toghrul-guluzade/AzSat-CanSat-APRSAF2025/images/image1.png

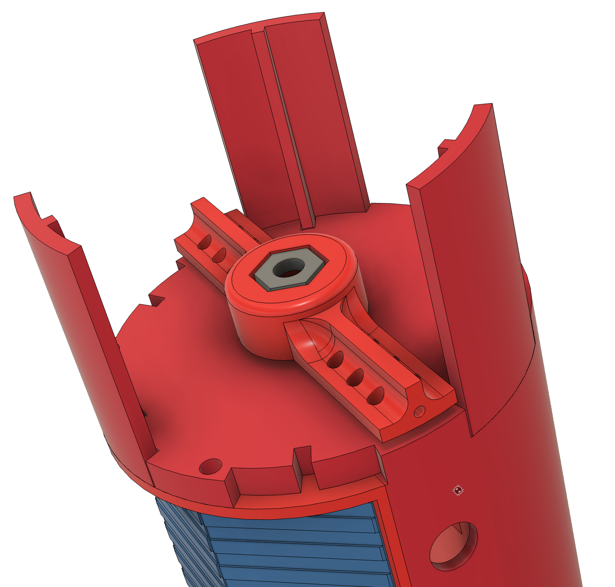
images/image1.png
