toghrul-guluzade/AzSat-CanSat-APRSAF2025/images/image2.png

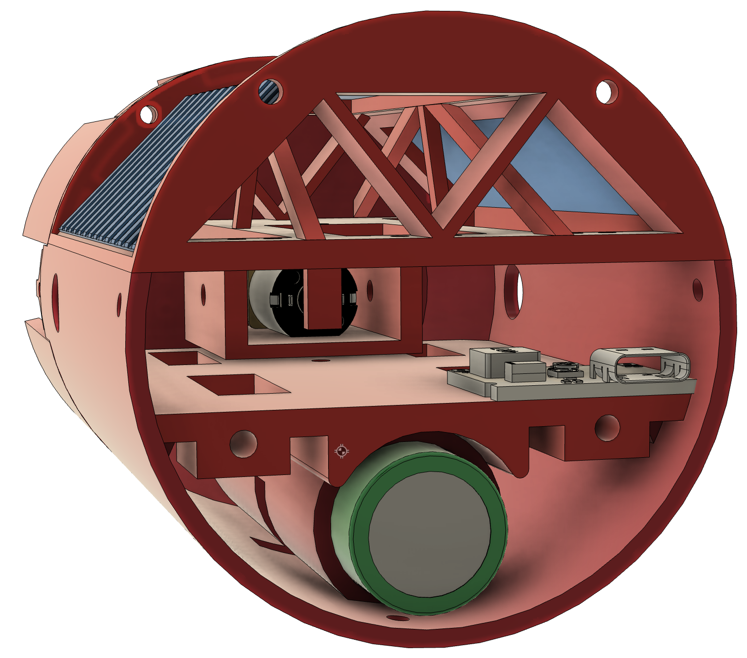
images/image2.png
