toghrul-guluzade/AzSat-CanSat-APRSAF2025/images/image3.png

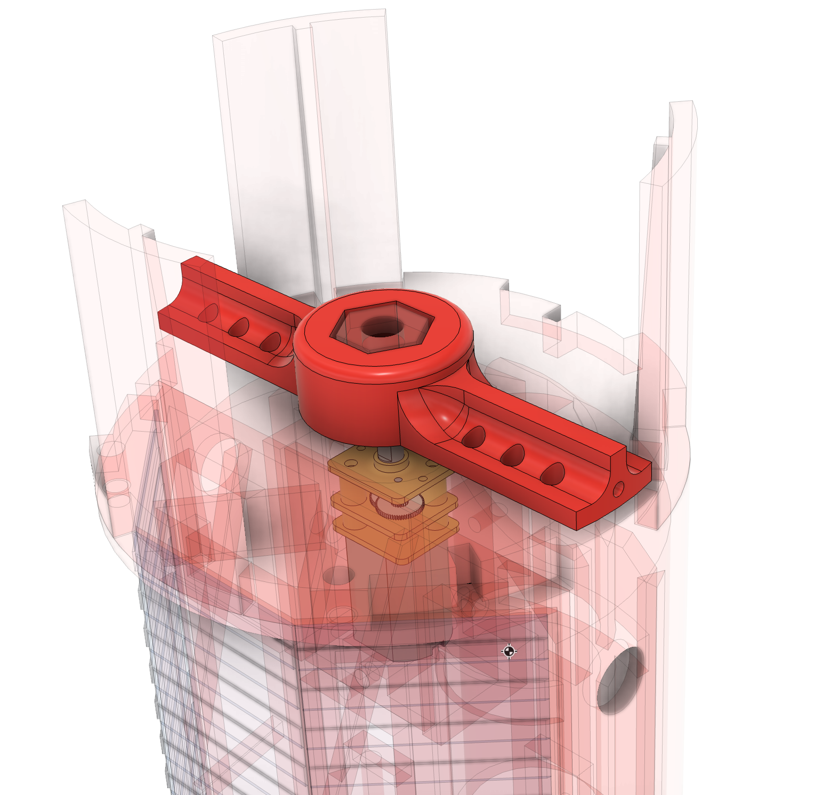
images/image3.png
