toghrul-guluzade/AzSat-CanSat-APRSAF2025/docs/MainAssemb Drawing v1.pdf

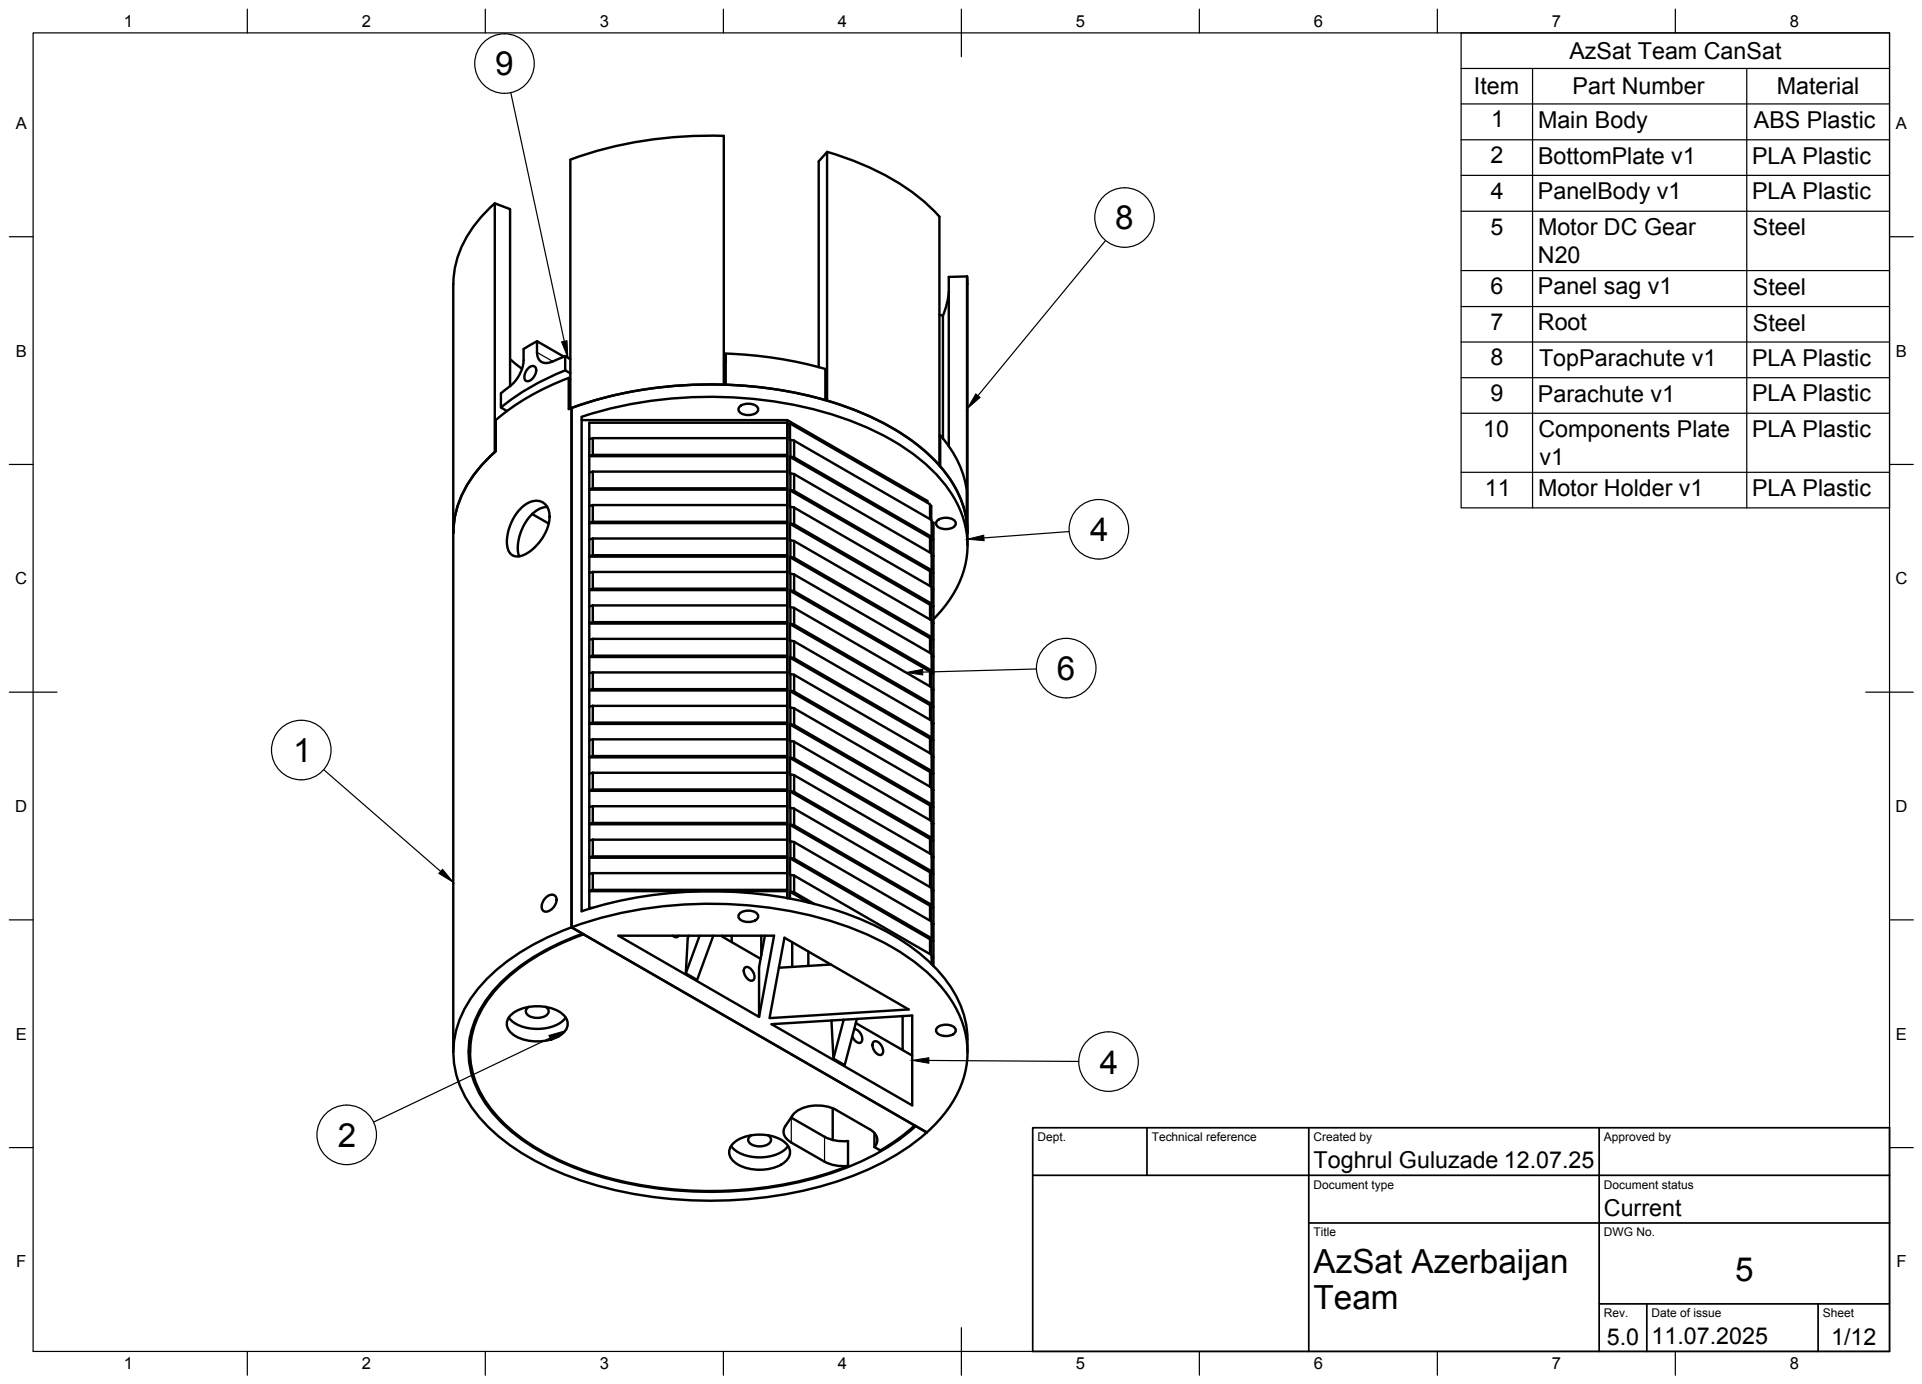
[picture p14: page 1]
8 BCDEF; ABCDEF; Title; DWG No.; Rev.; Date of issue; Sheet; AzSat Azerbaijan; Components Plate; PLA Plastic; Motor Holder v1; PLA Plastic 1 2

AzSat Team CanSat

Item | PanelBody v1 Main Body BottomPlate v1 Motor DC Gear Part Number | PLA Plastic 4 PLA Plastic 5 ABS Plastic 2 Material 1

Panel sag v1 Root Parachute v1 TopParachute v1 | PLA Plastic 9 PLA Plastic Steel 6 Steel 7 Steel 8
N20

Dept. | Technical reference | Created by Toghrul Guluzade 12.07.25 | Approved by

Document type | Document status Current

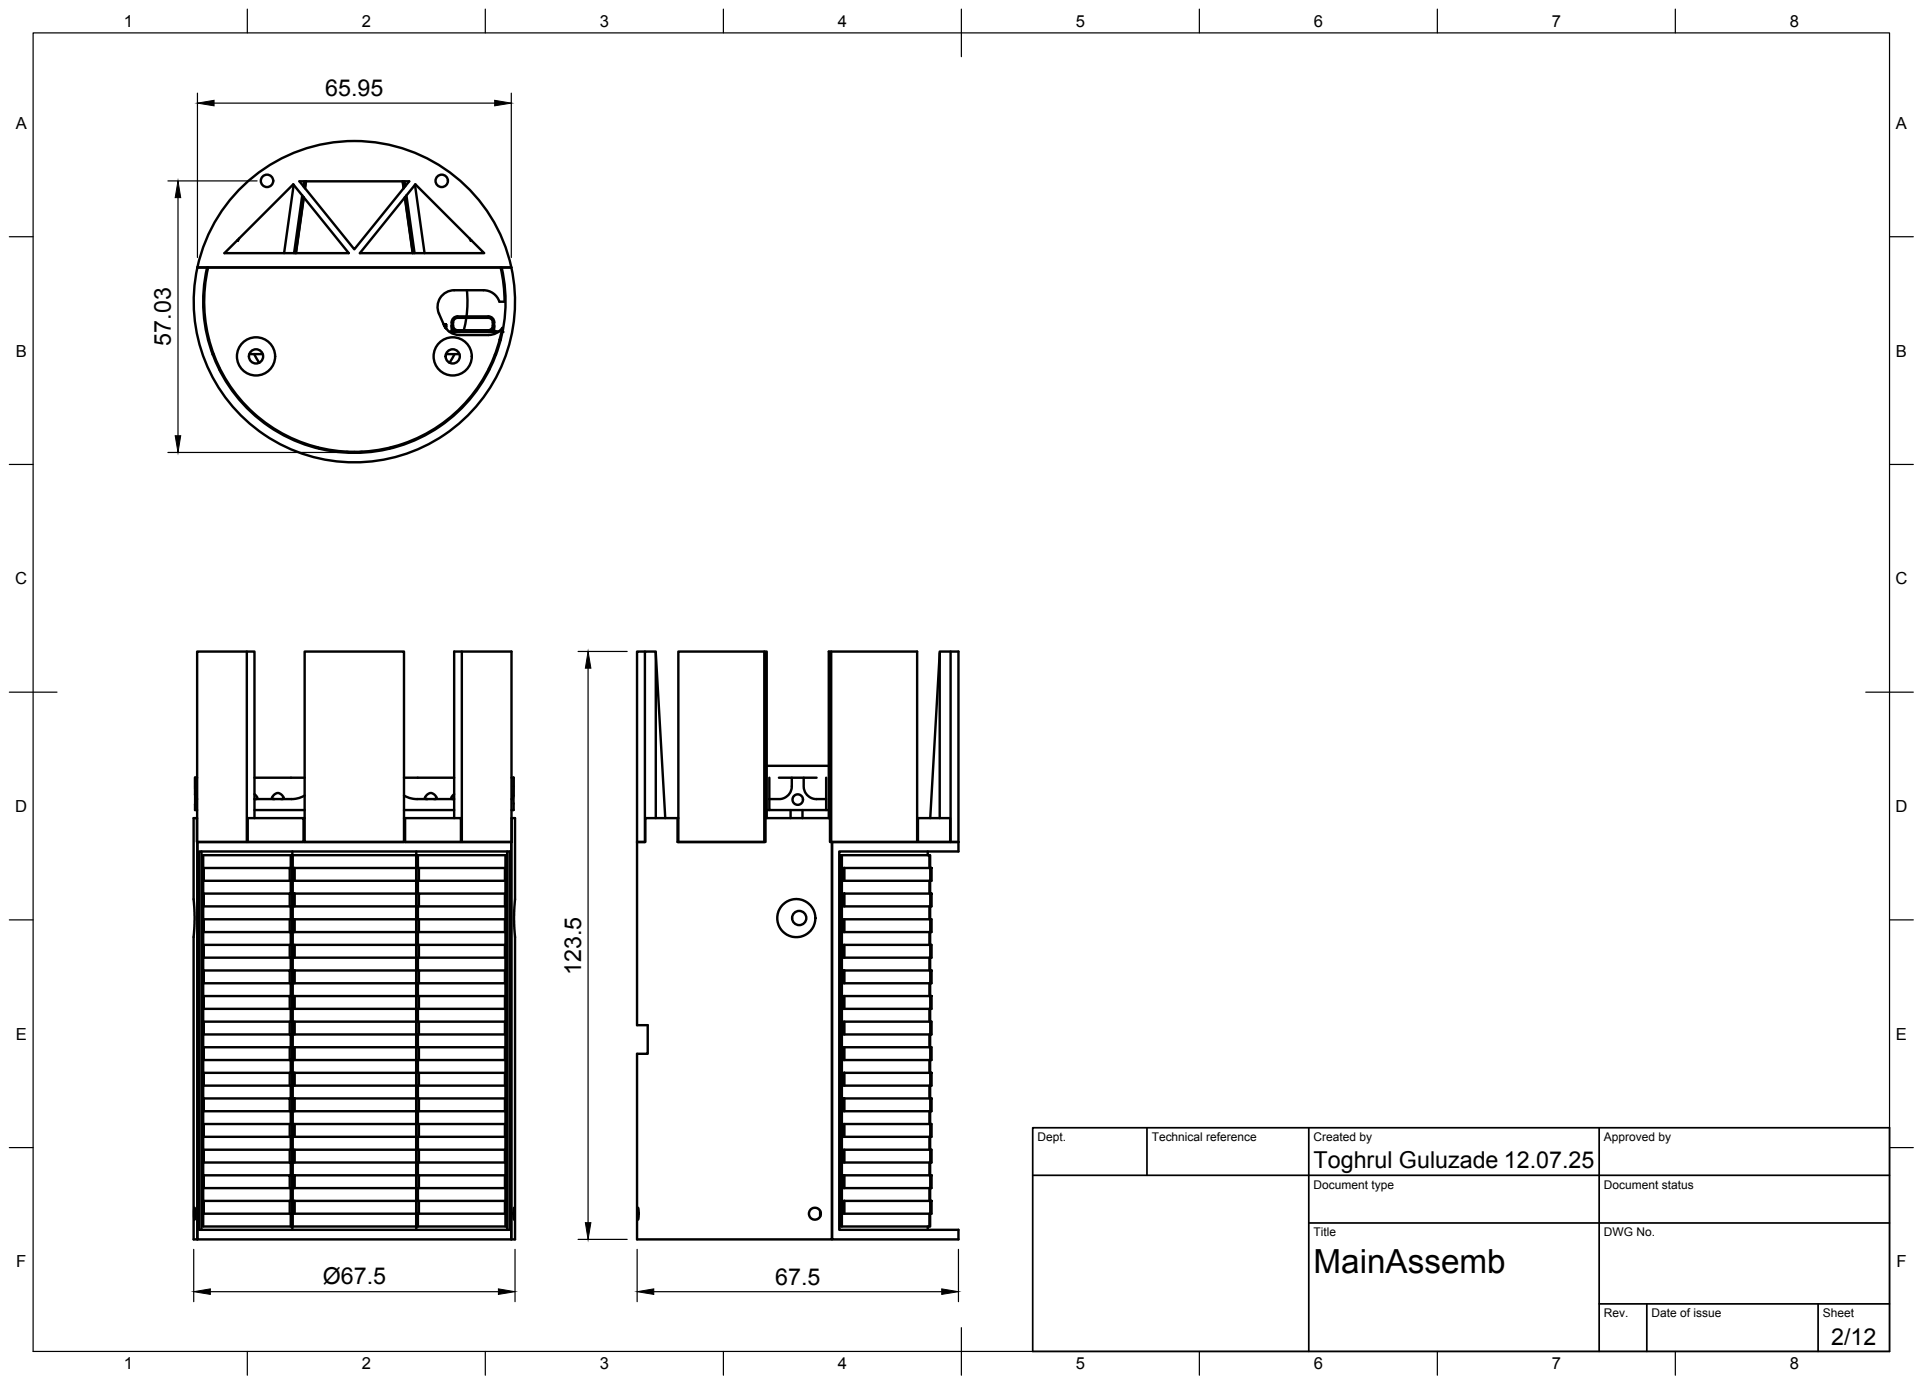
[picture p15: page 2]
Title; DWG No.

Dept. | Technical reference | Created by Toghrul Guluzade 12.07.25 | Approved by

Document type | Document status

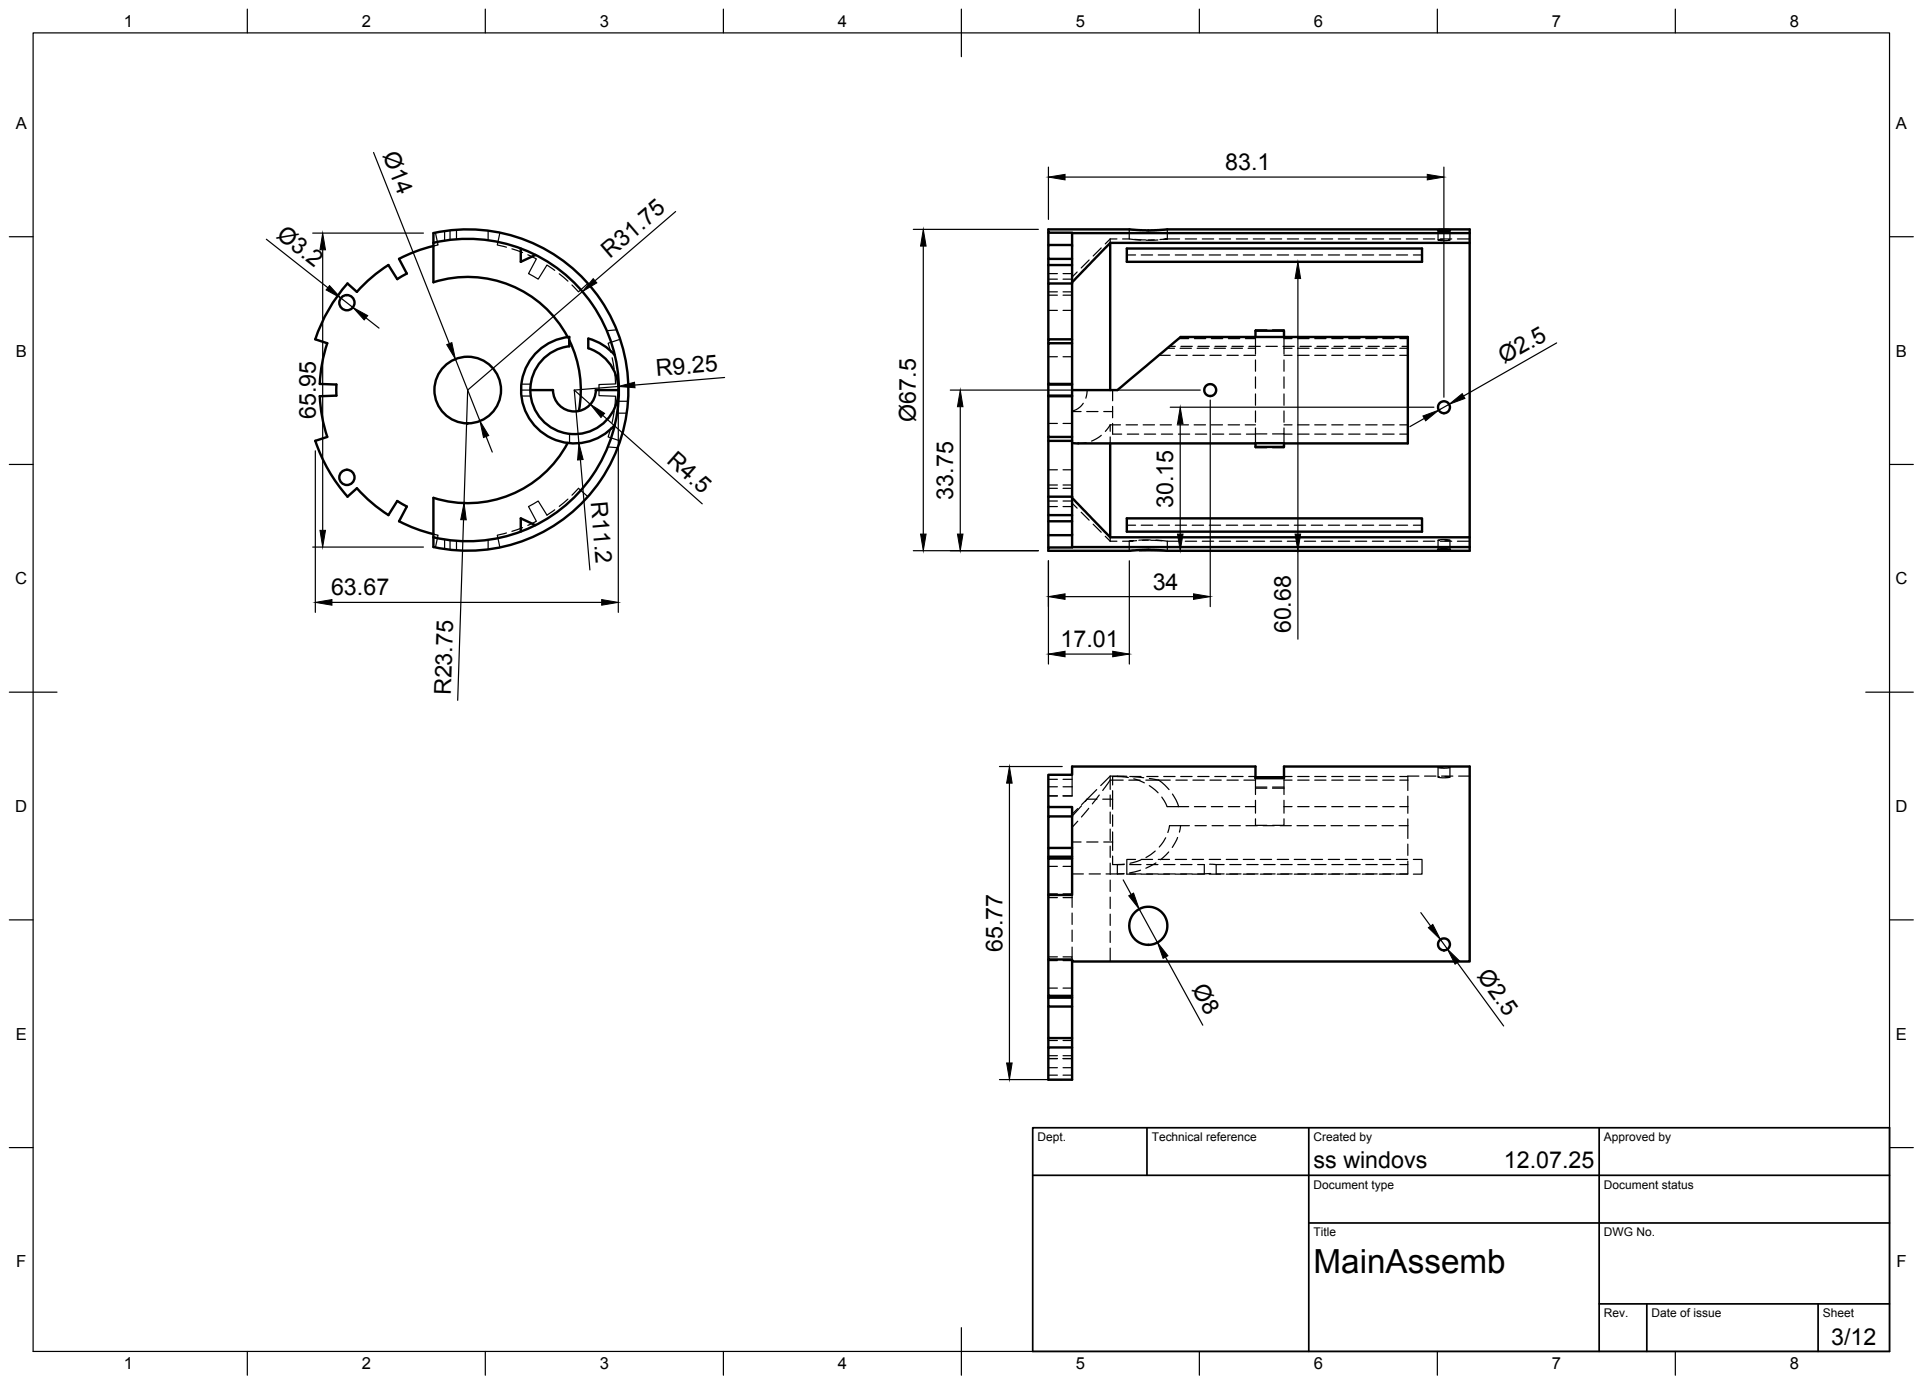
[picture p16: page 3]
Title; DWG No.

Dept. | Technical reference | Created by ss windovs 12.07.25 | Approved by

Document type | Document status

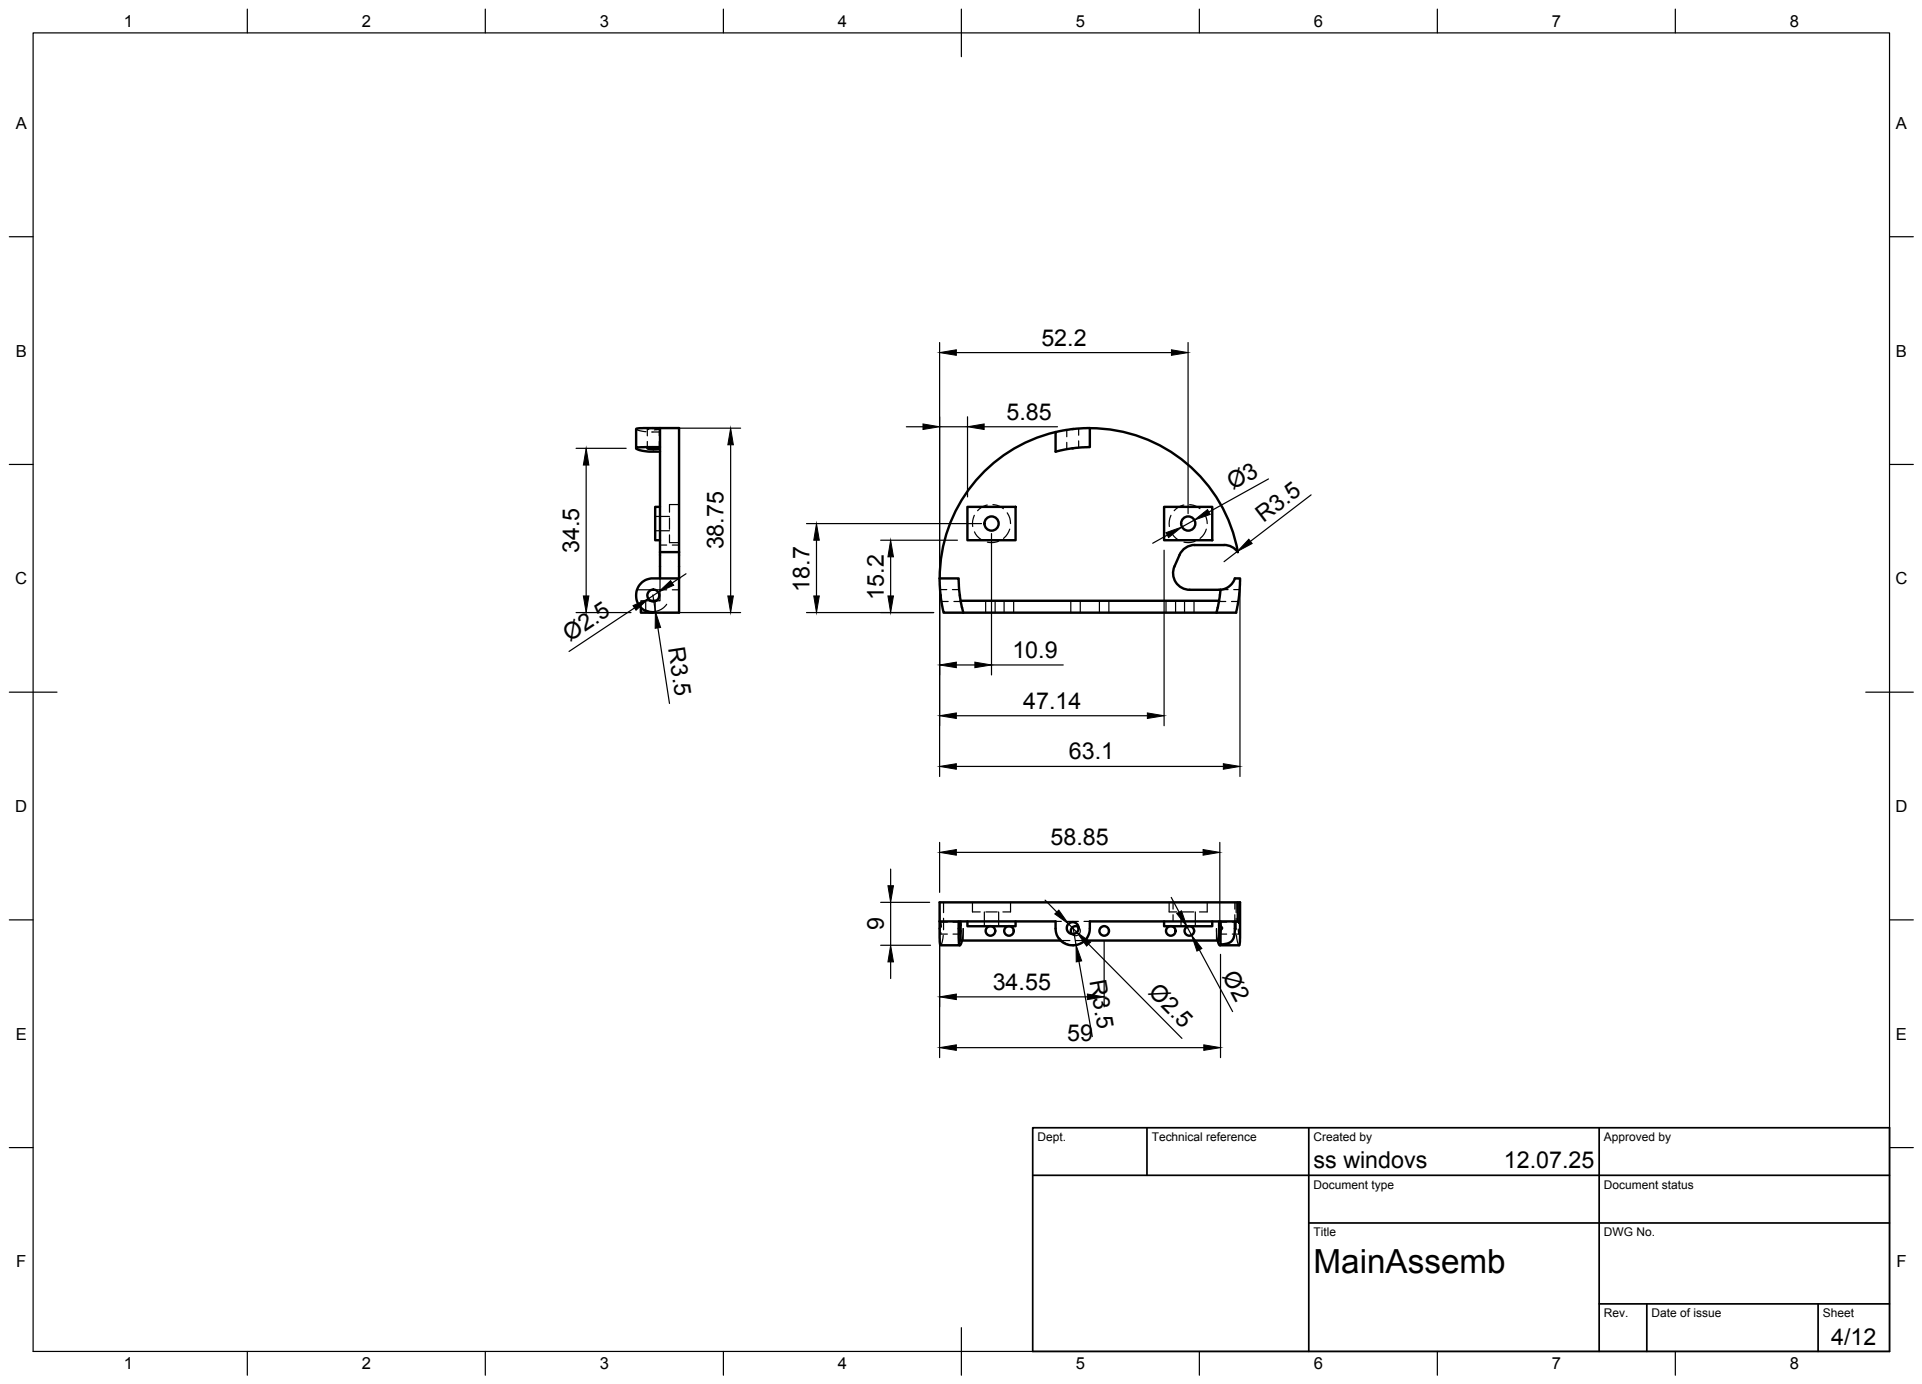
[picture p17: page 4]
Title; DWG No.

Dept. | Technical reference | Created by ss windovs 12.07.25 | Approved by

Document type | Document status

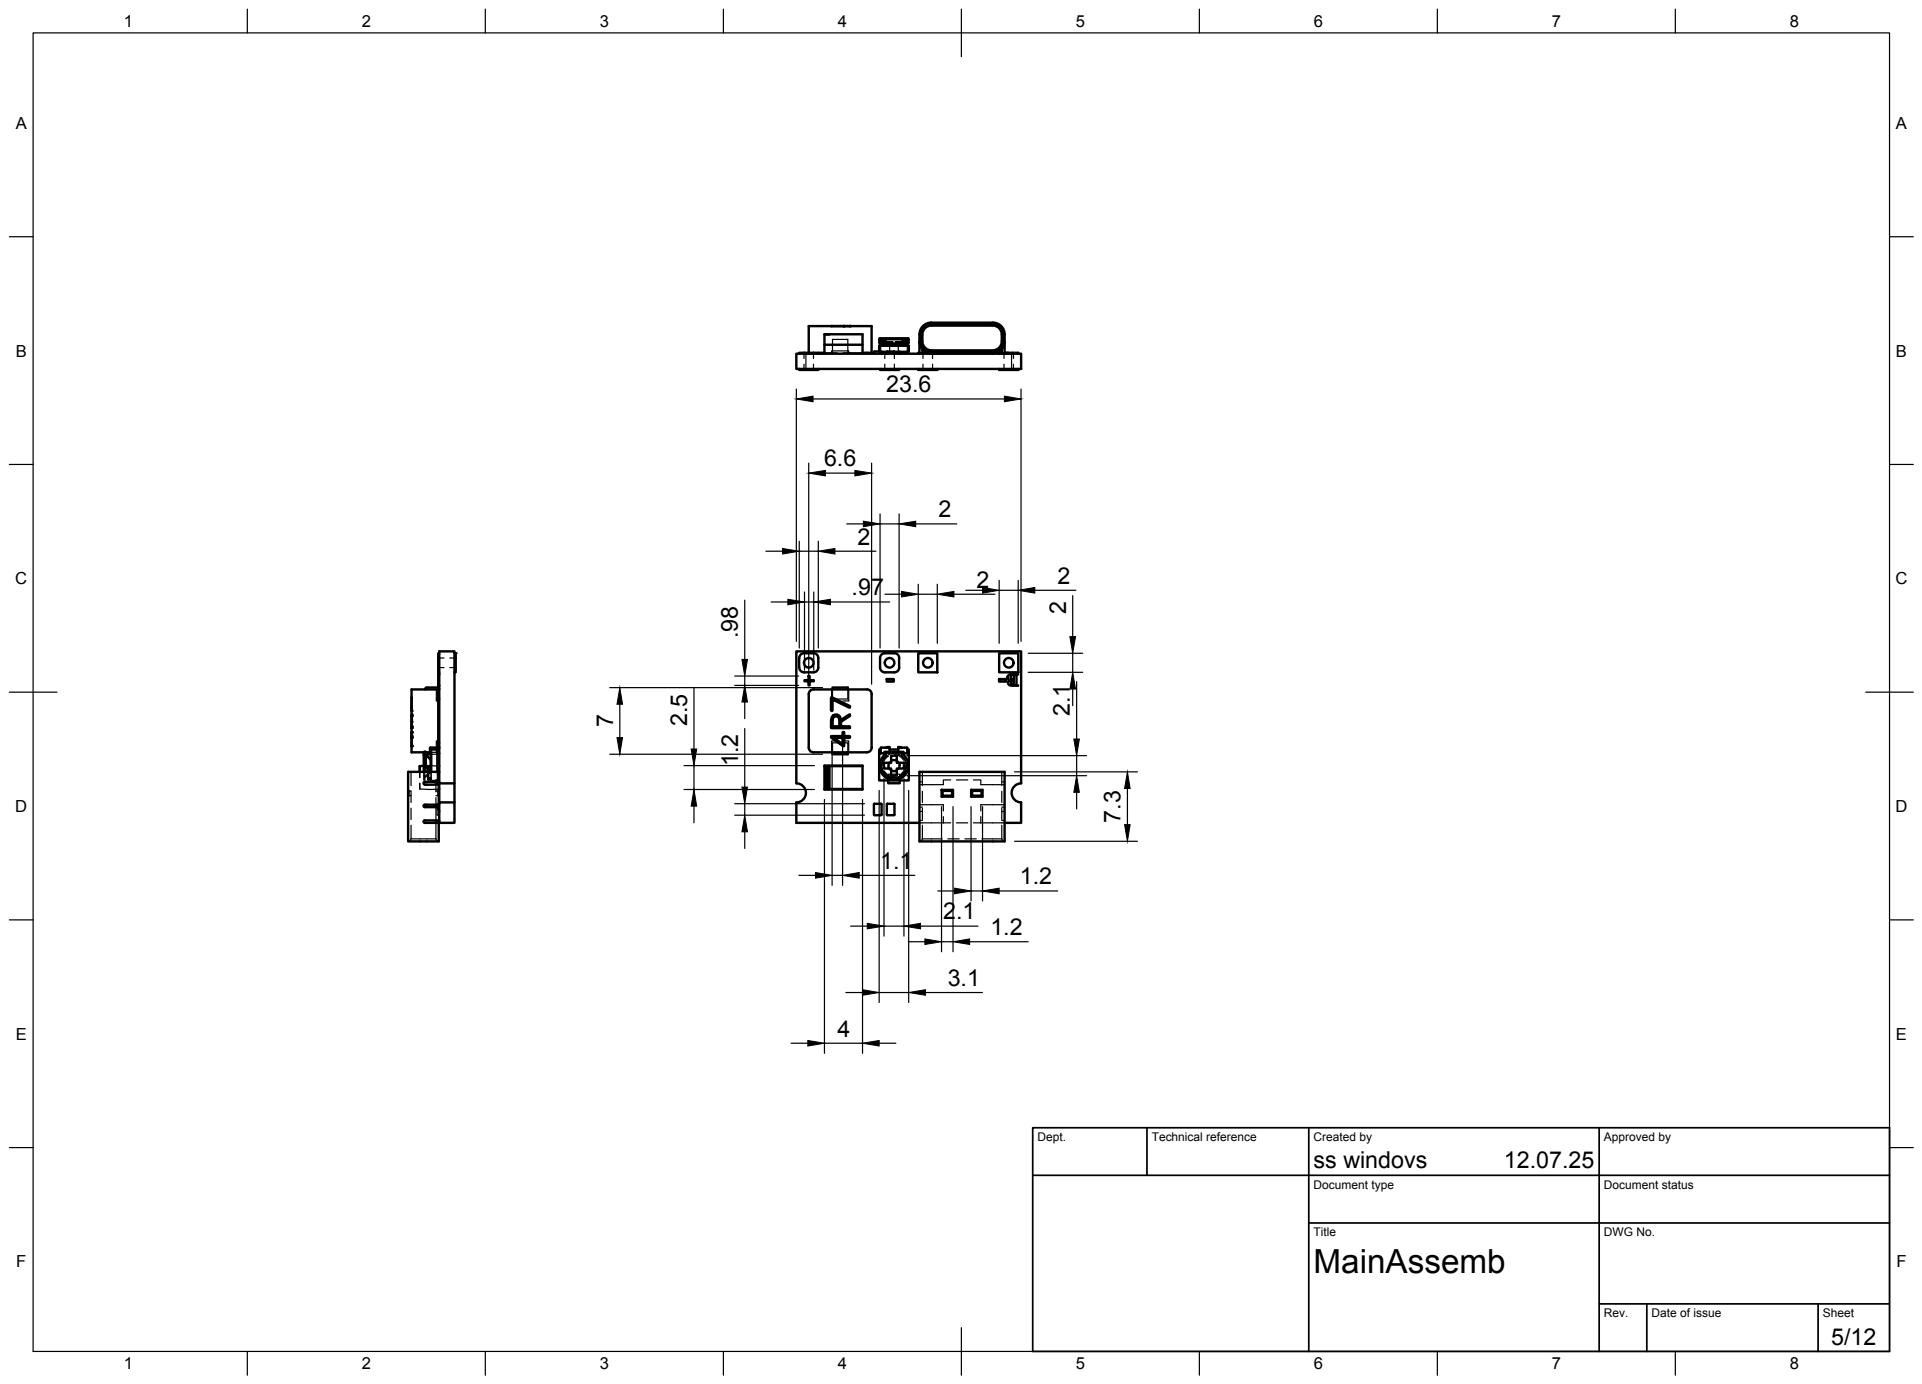
[picture p18: page 5]
Title; DWG No.

Dept. | Technical reference | Created by ss windovs 12.07.25 | Approved by

Document type | Document status

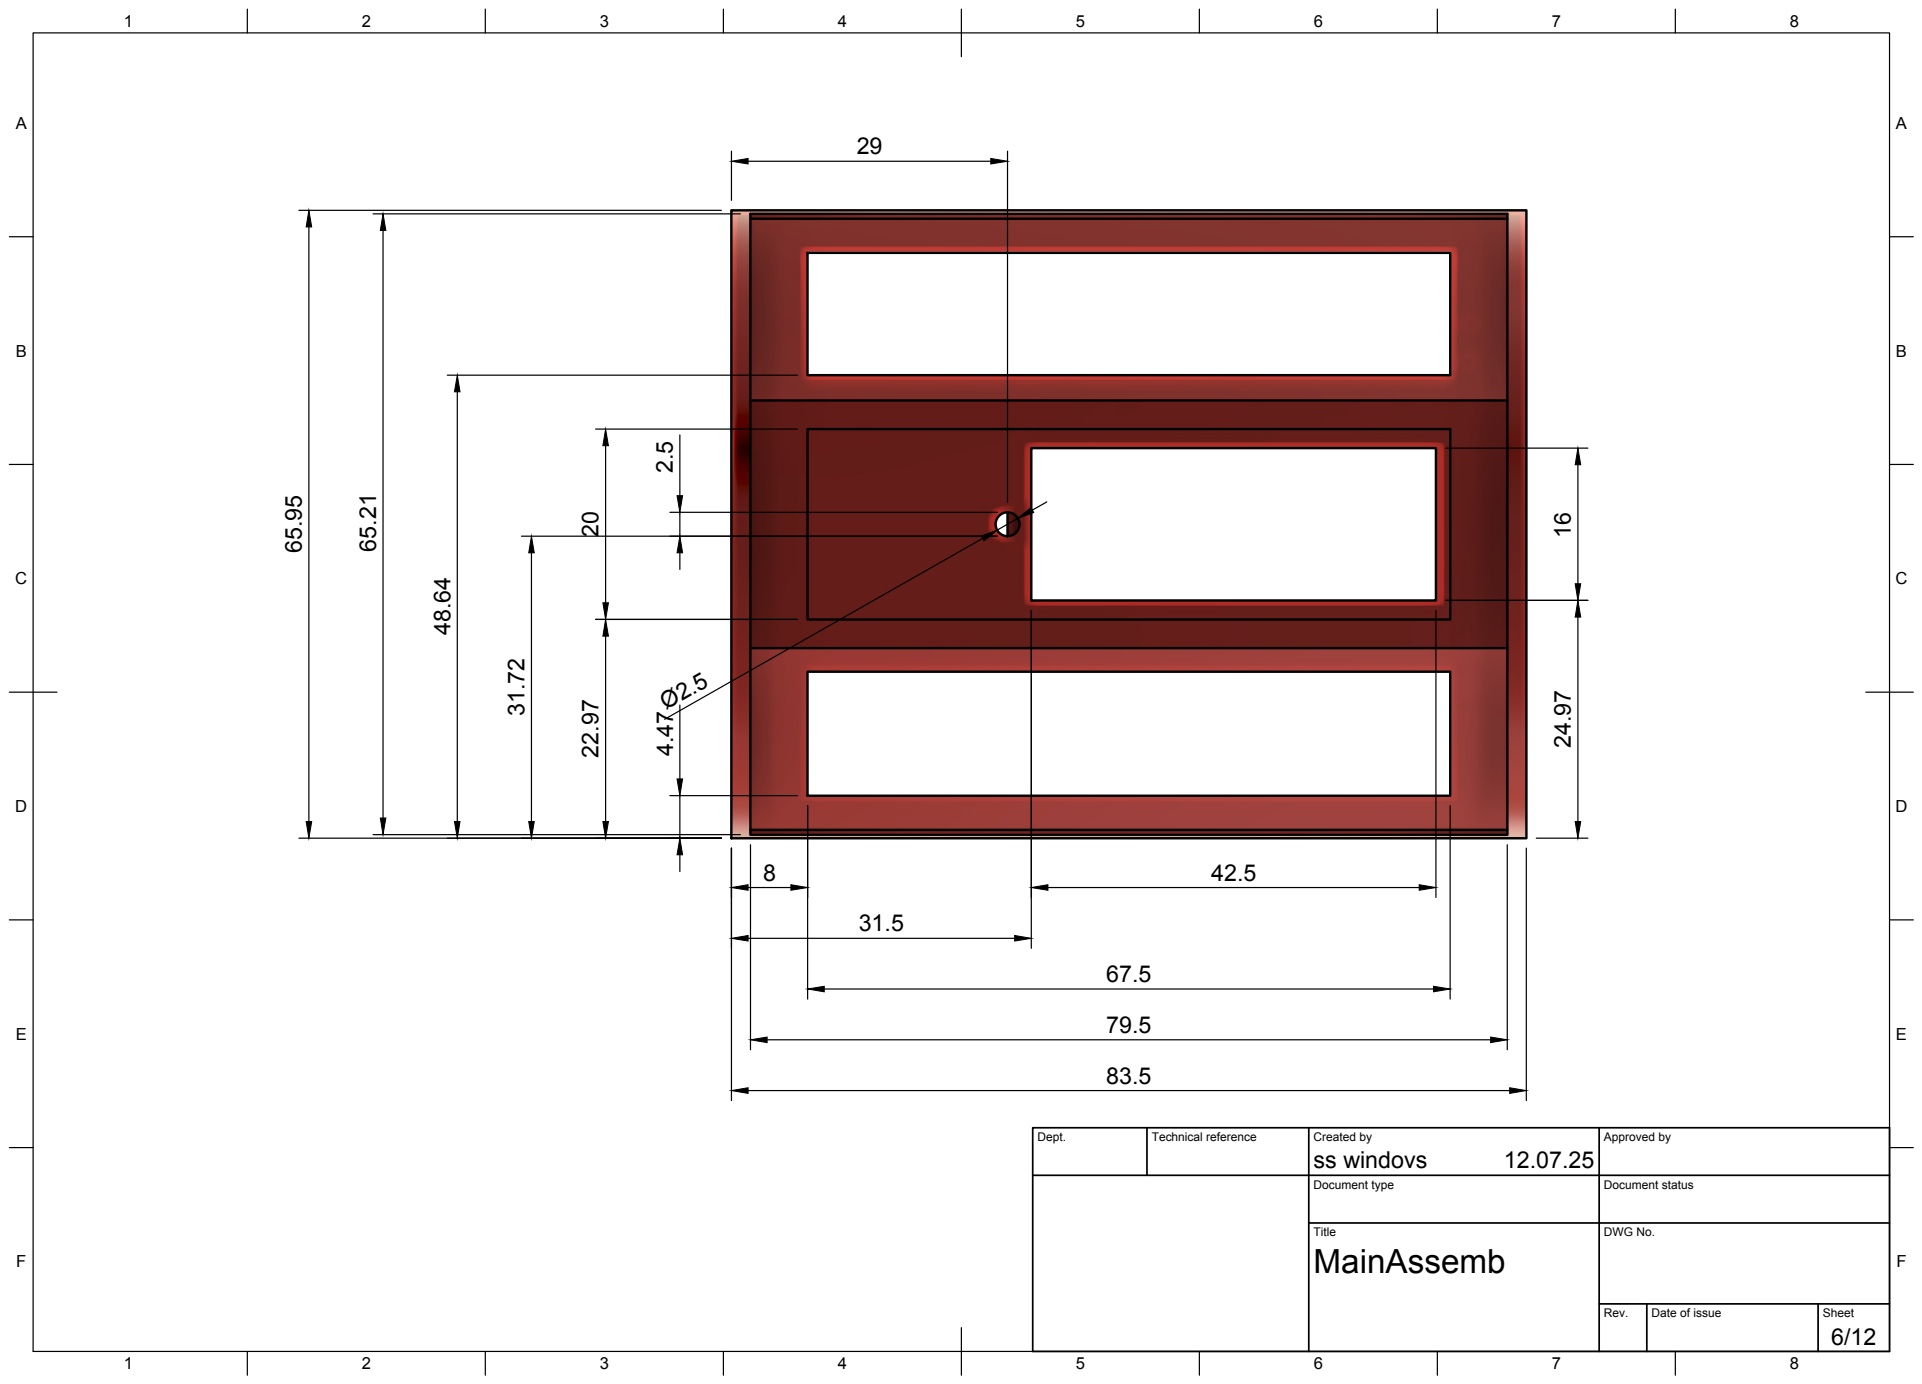
[picture p19: page 6]
Title; DWG No.

Dept. | Technical reference | Created by ss windovs 12.07.25 | Approved by

Document type | Document status

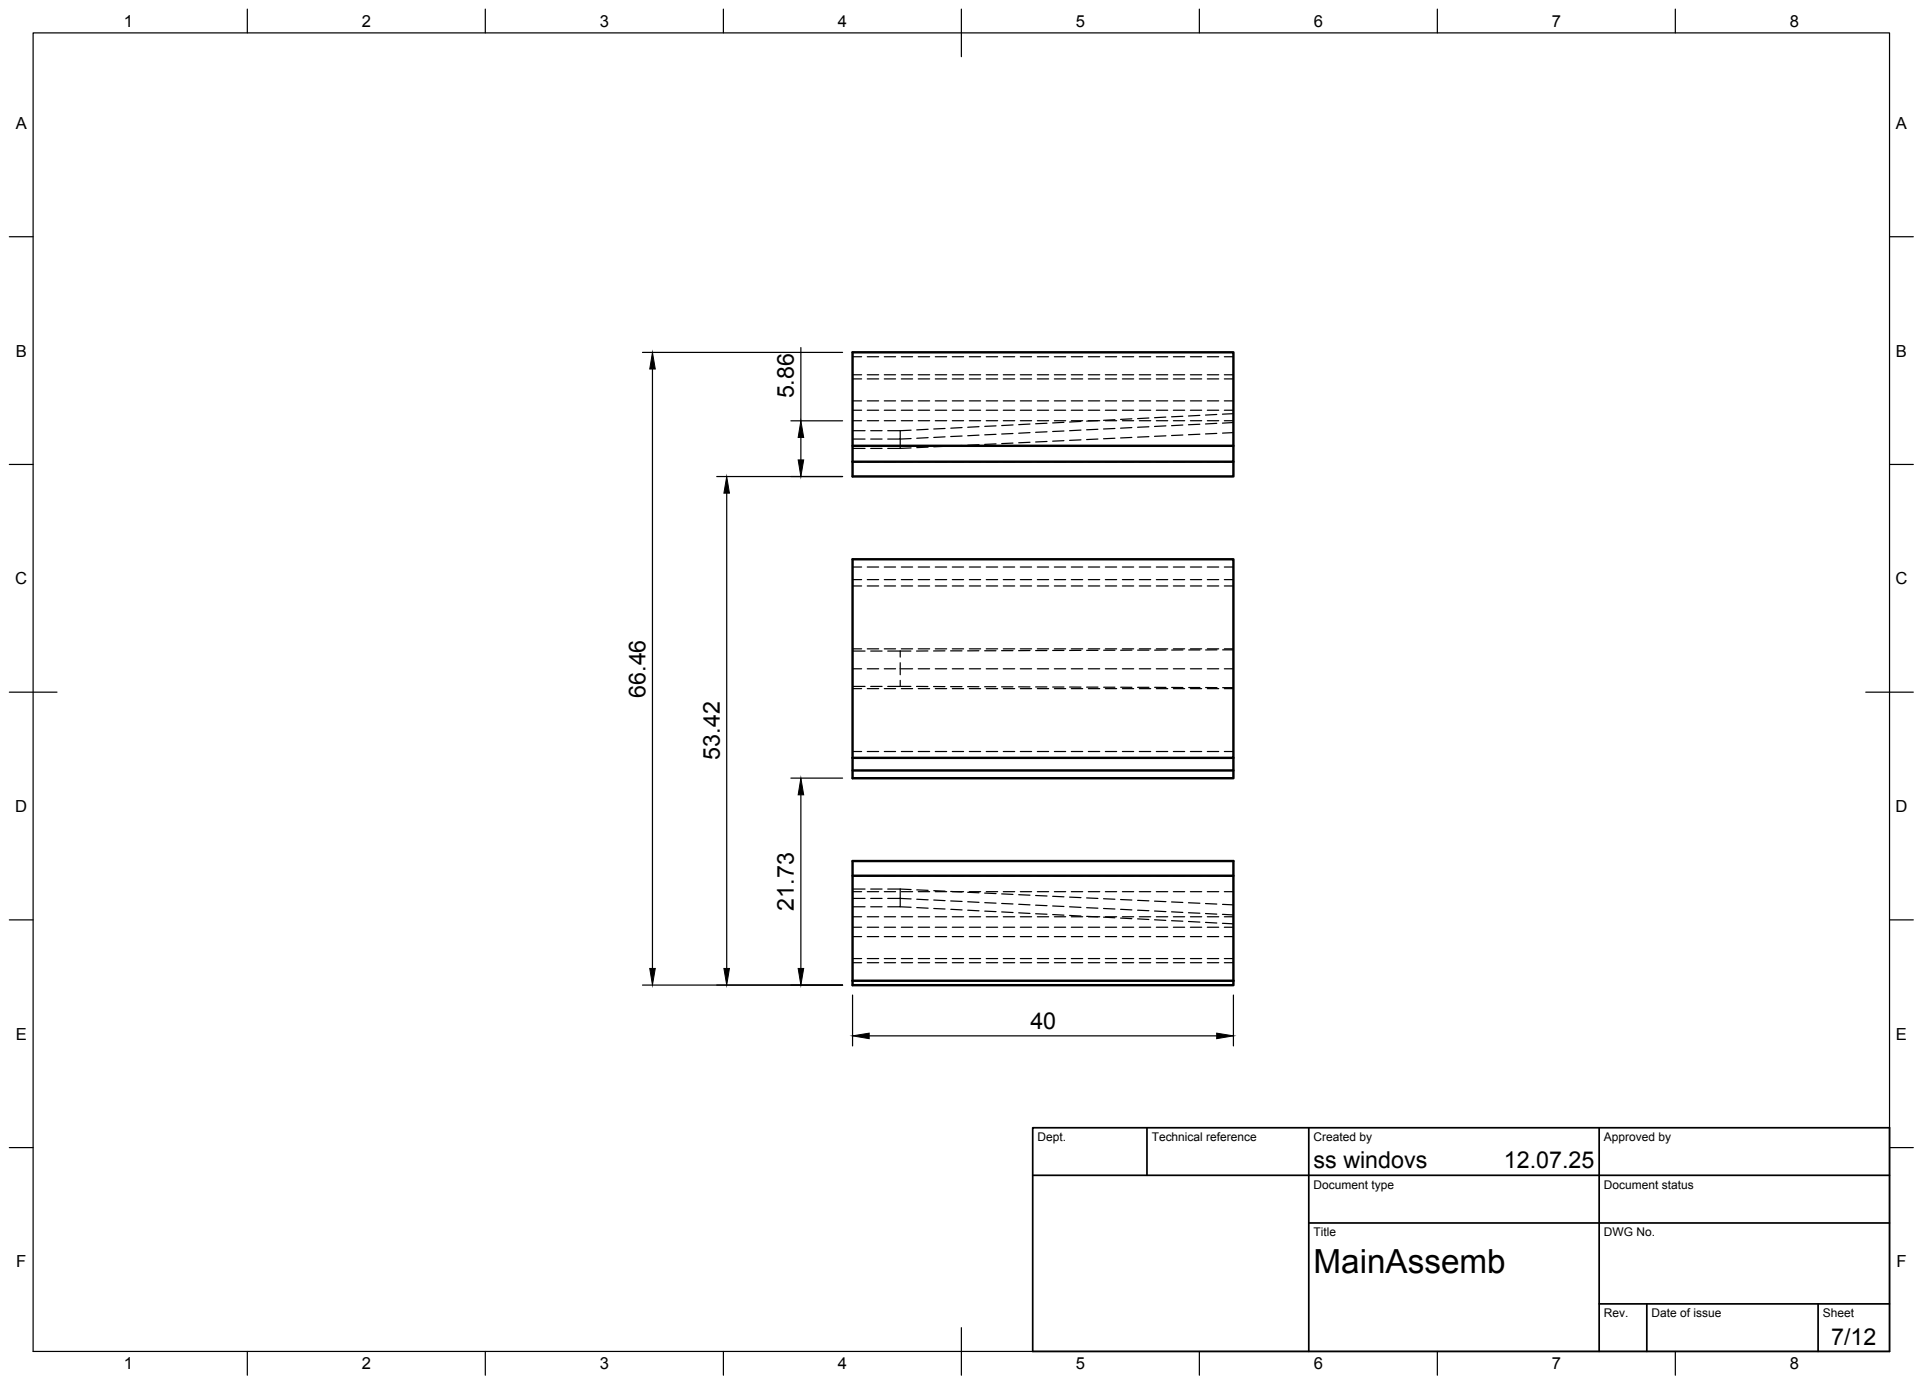
[picture p20: page 7]
Title; DWG No.; ss windovs 66.46

Dept. | Technical reference | Created by 12.07.25 | Approved by

Document type | Document status

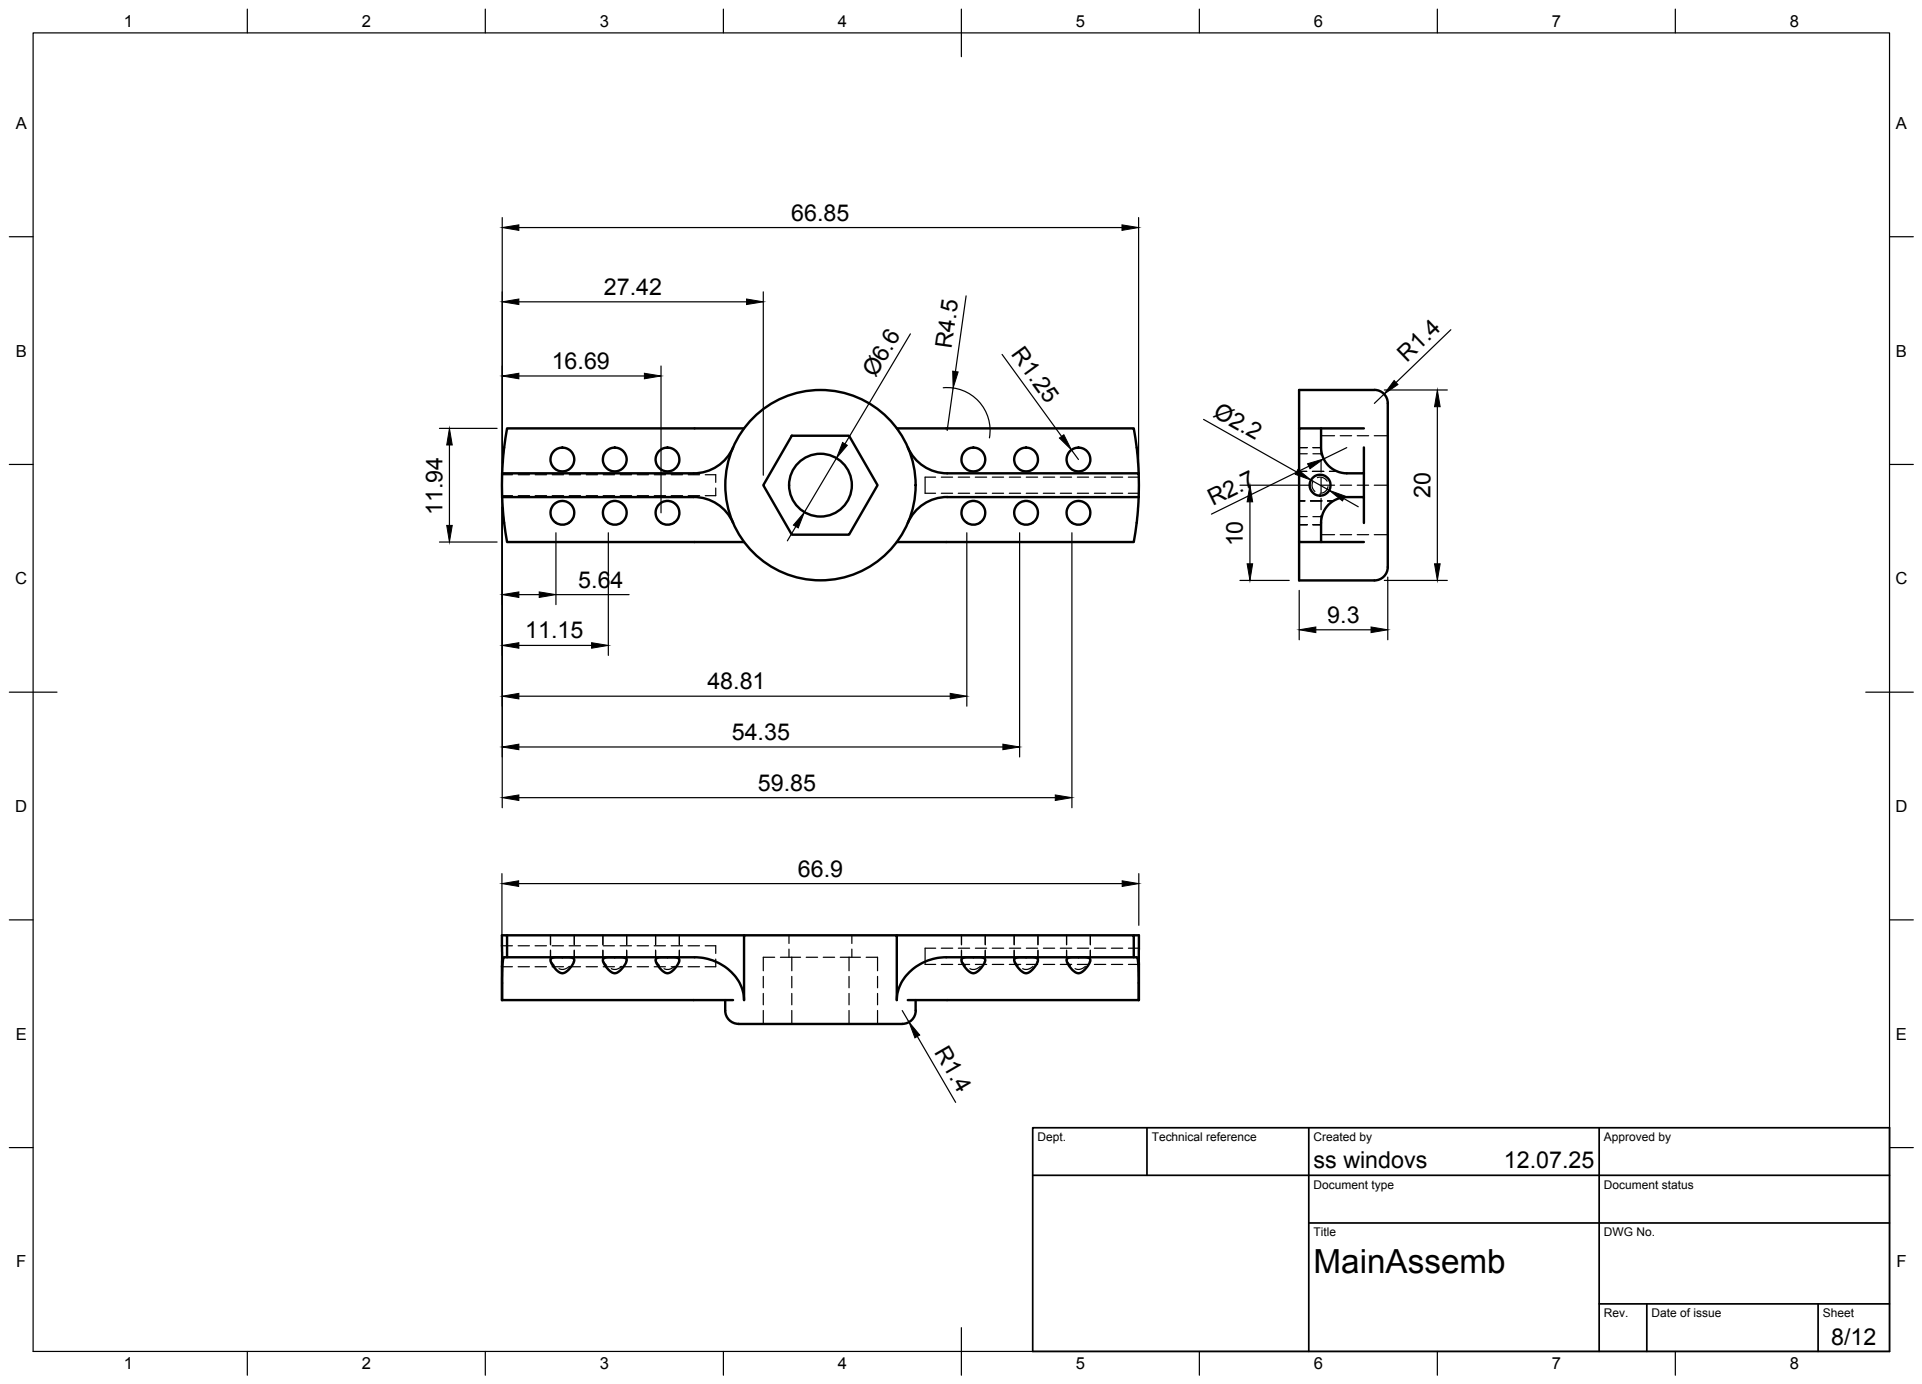
[picture p21: page 8]
Title; DWG No.

Dept. | Technical reference | Created by ss windovs 12.07.25 | Approved by

Document type | Document status

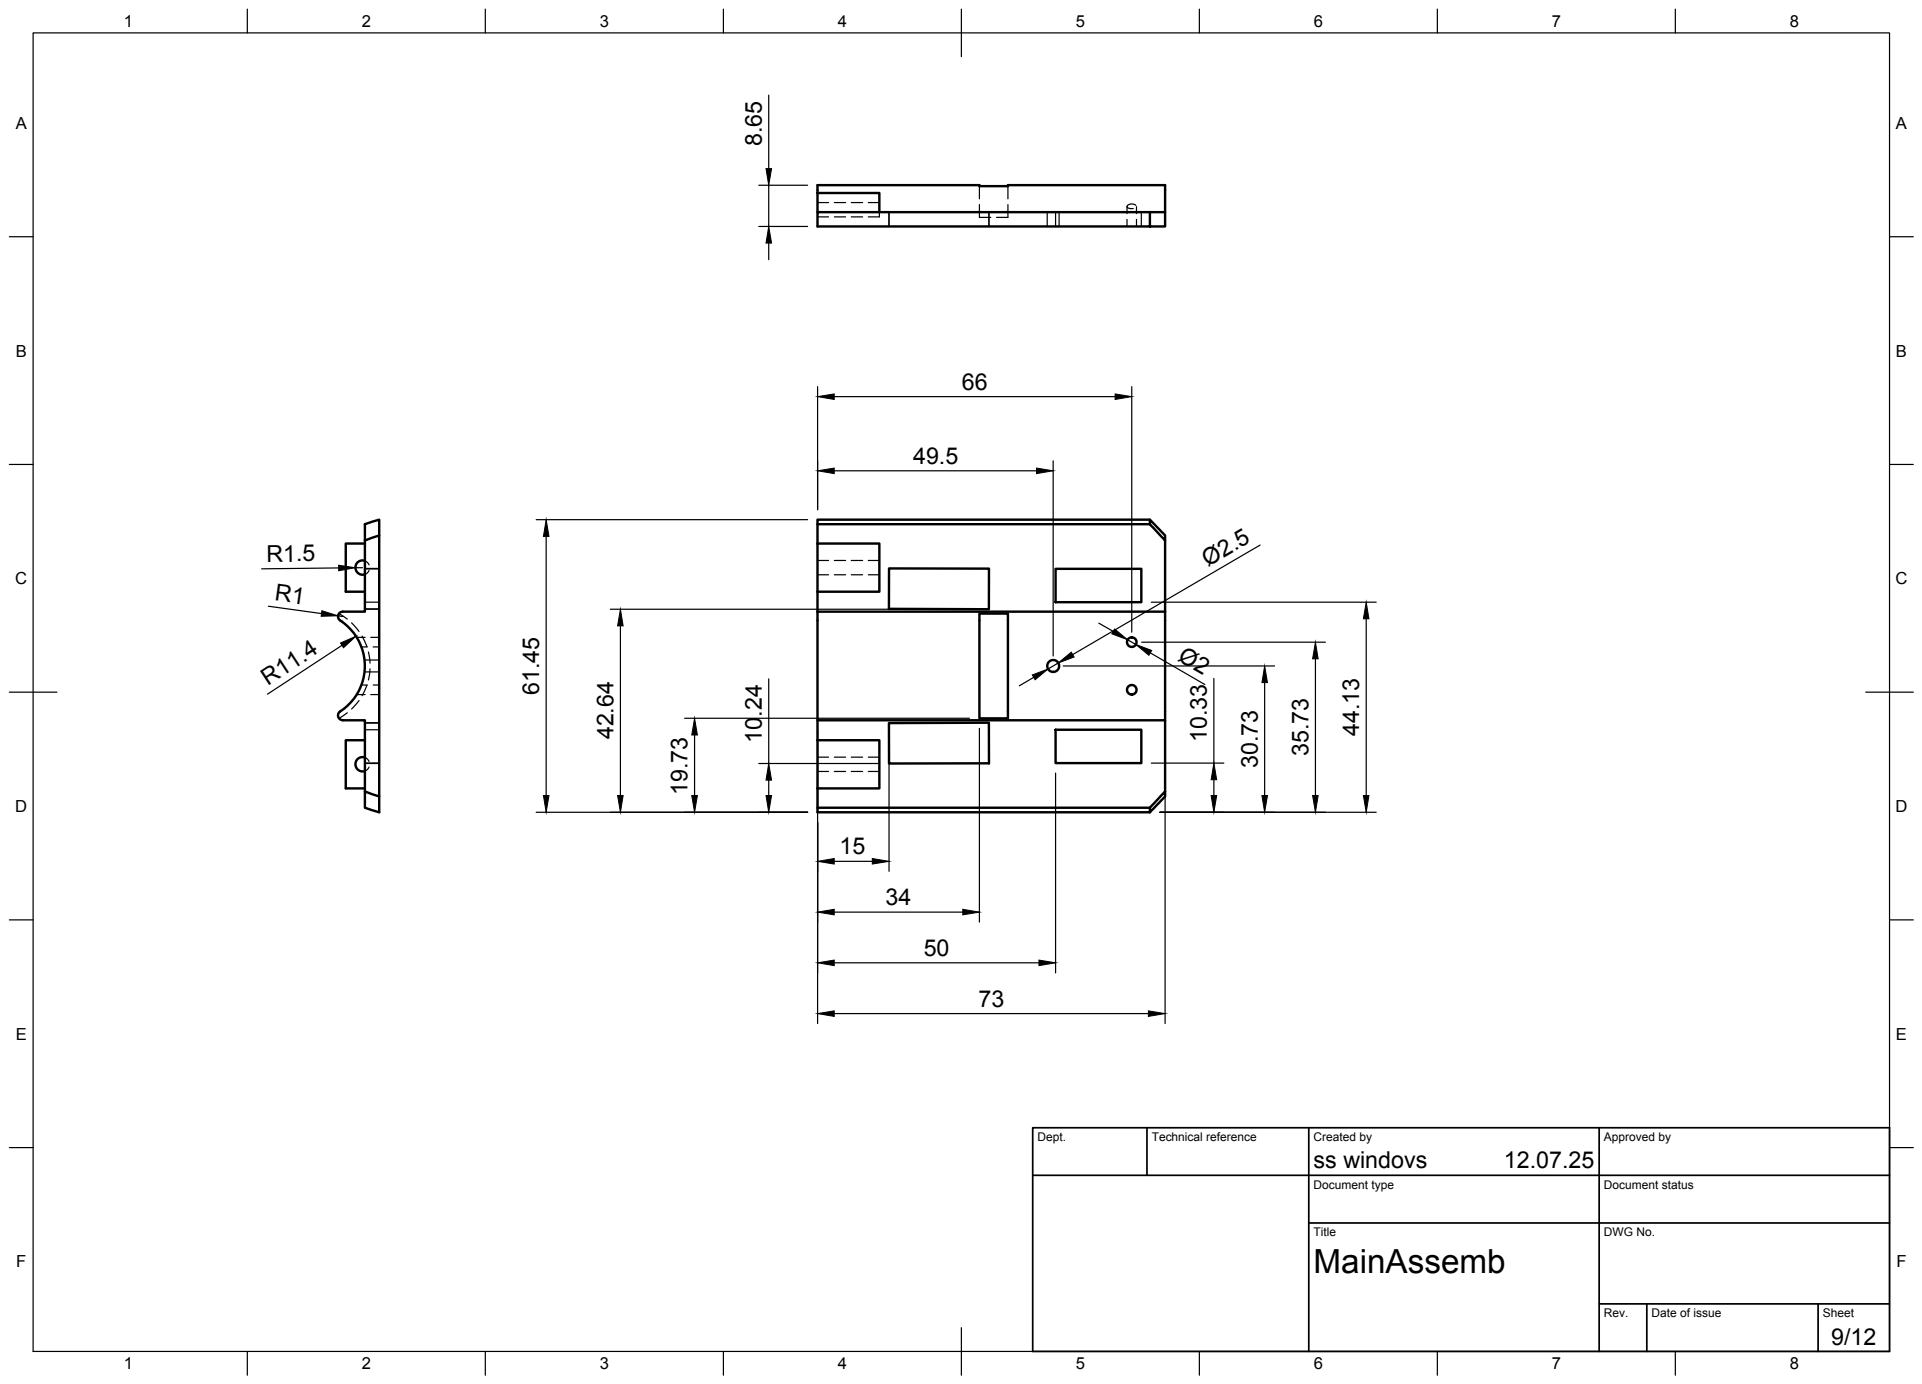
[picture p22: page 9]
Title; DWG No.

Dept. | Technical reference | Created by ss windovs 12.07.25 | Approved by

Document type | Document status

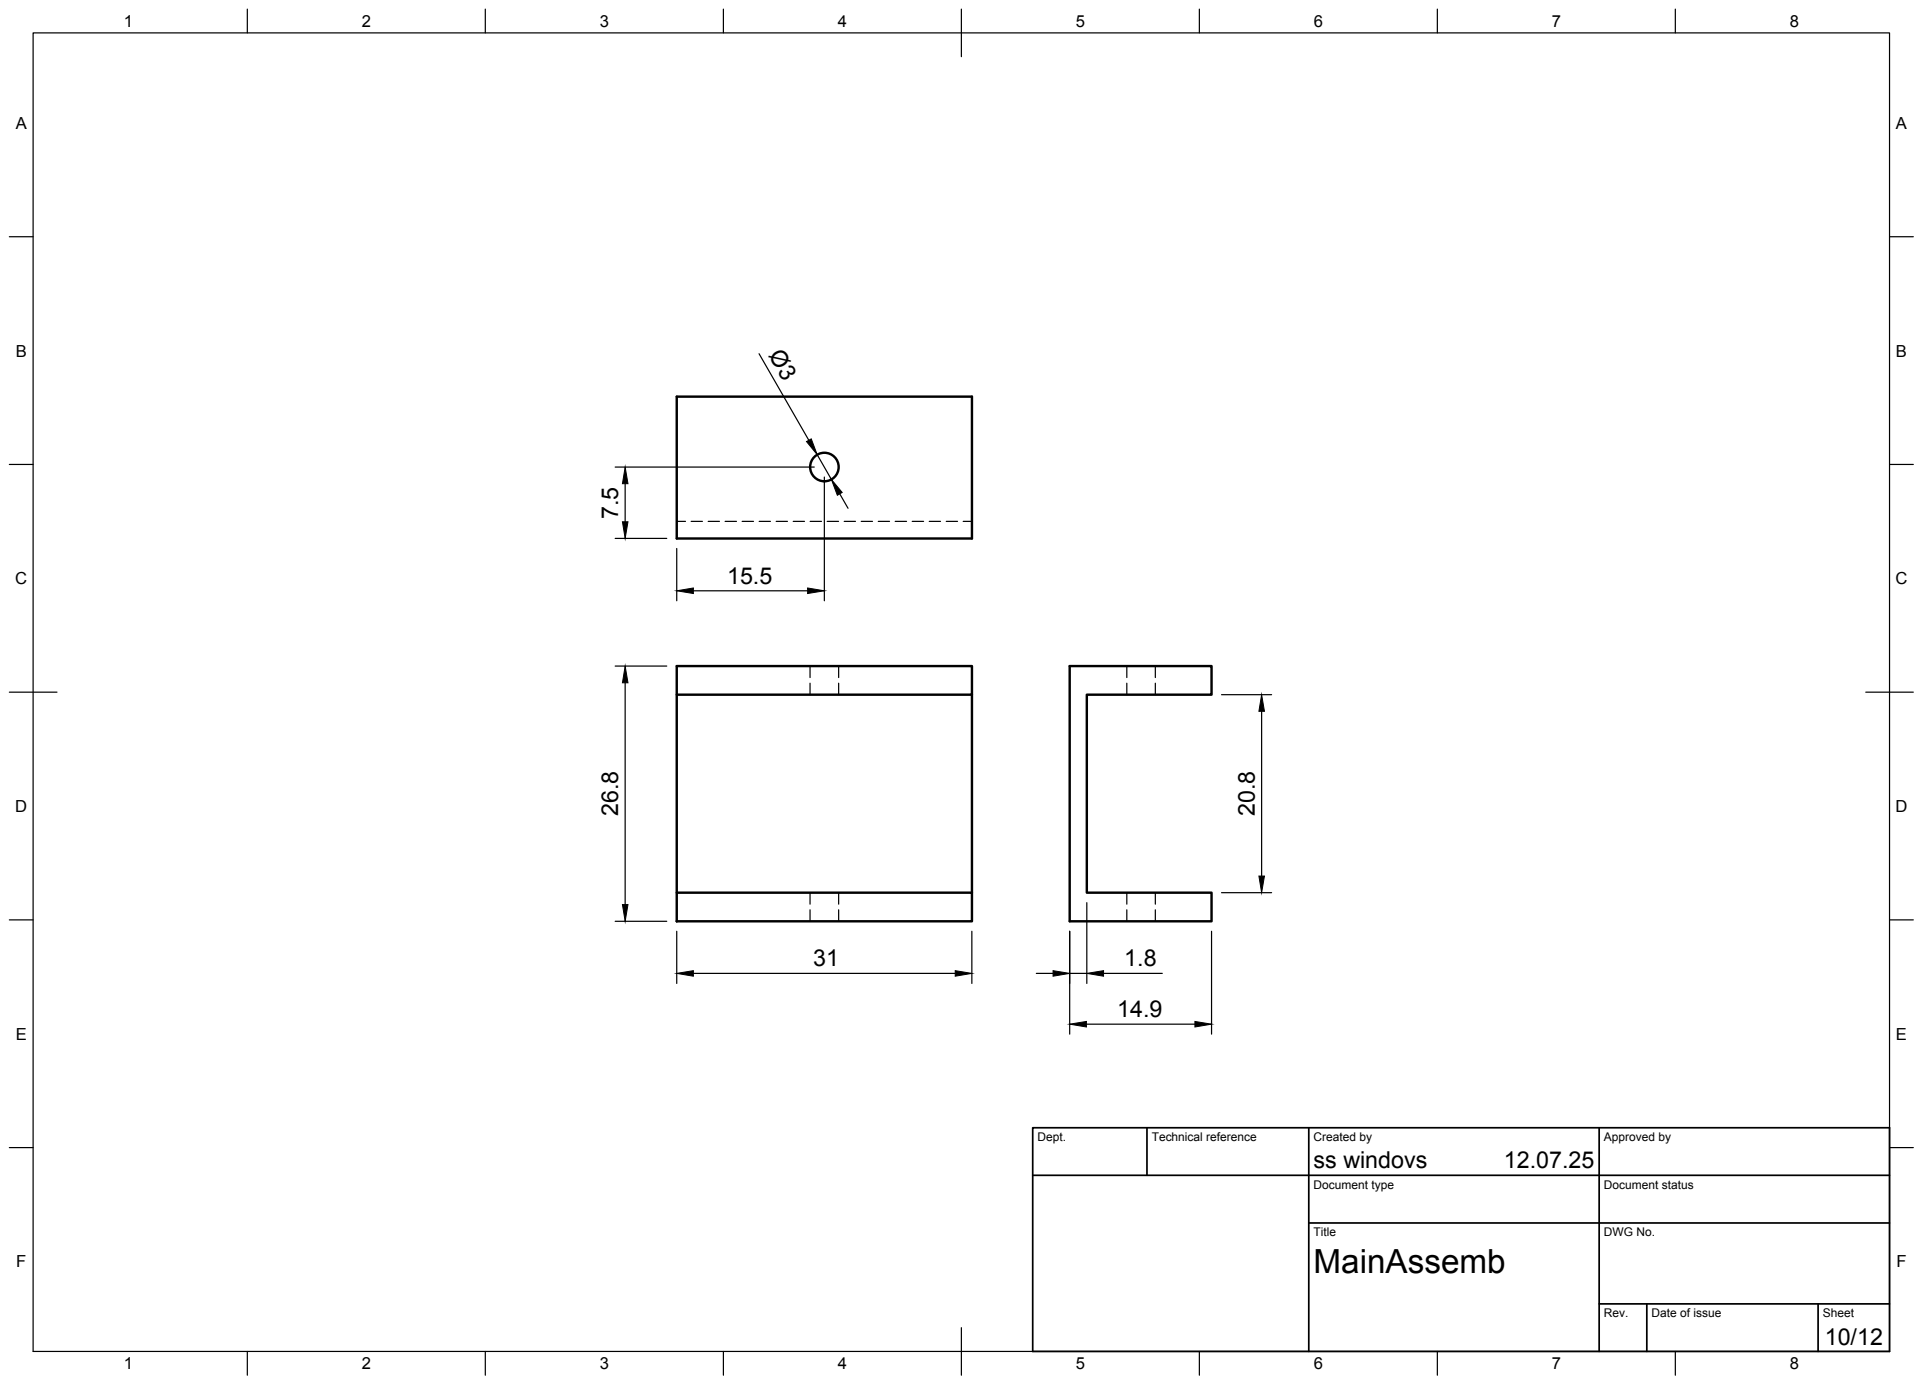
[picture p23: page 10]
Title; DWG No.

Dept. | Technical reference | Created by ss windovs 12.07.25 | Approved by

Document type | Document status

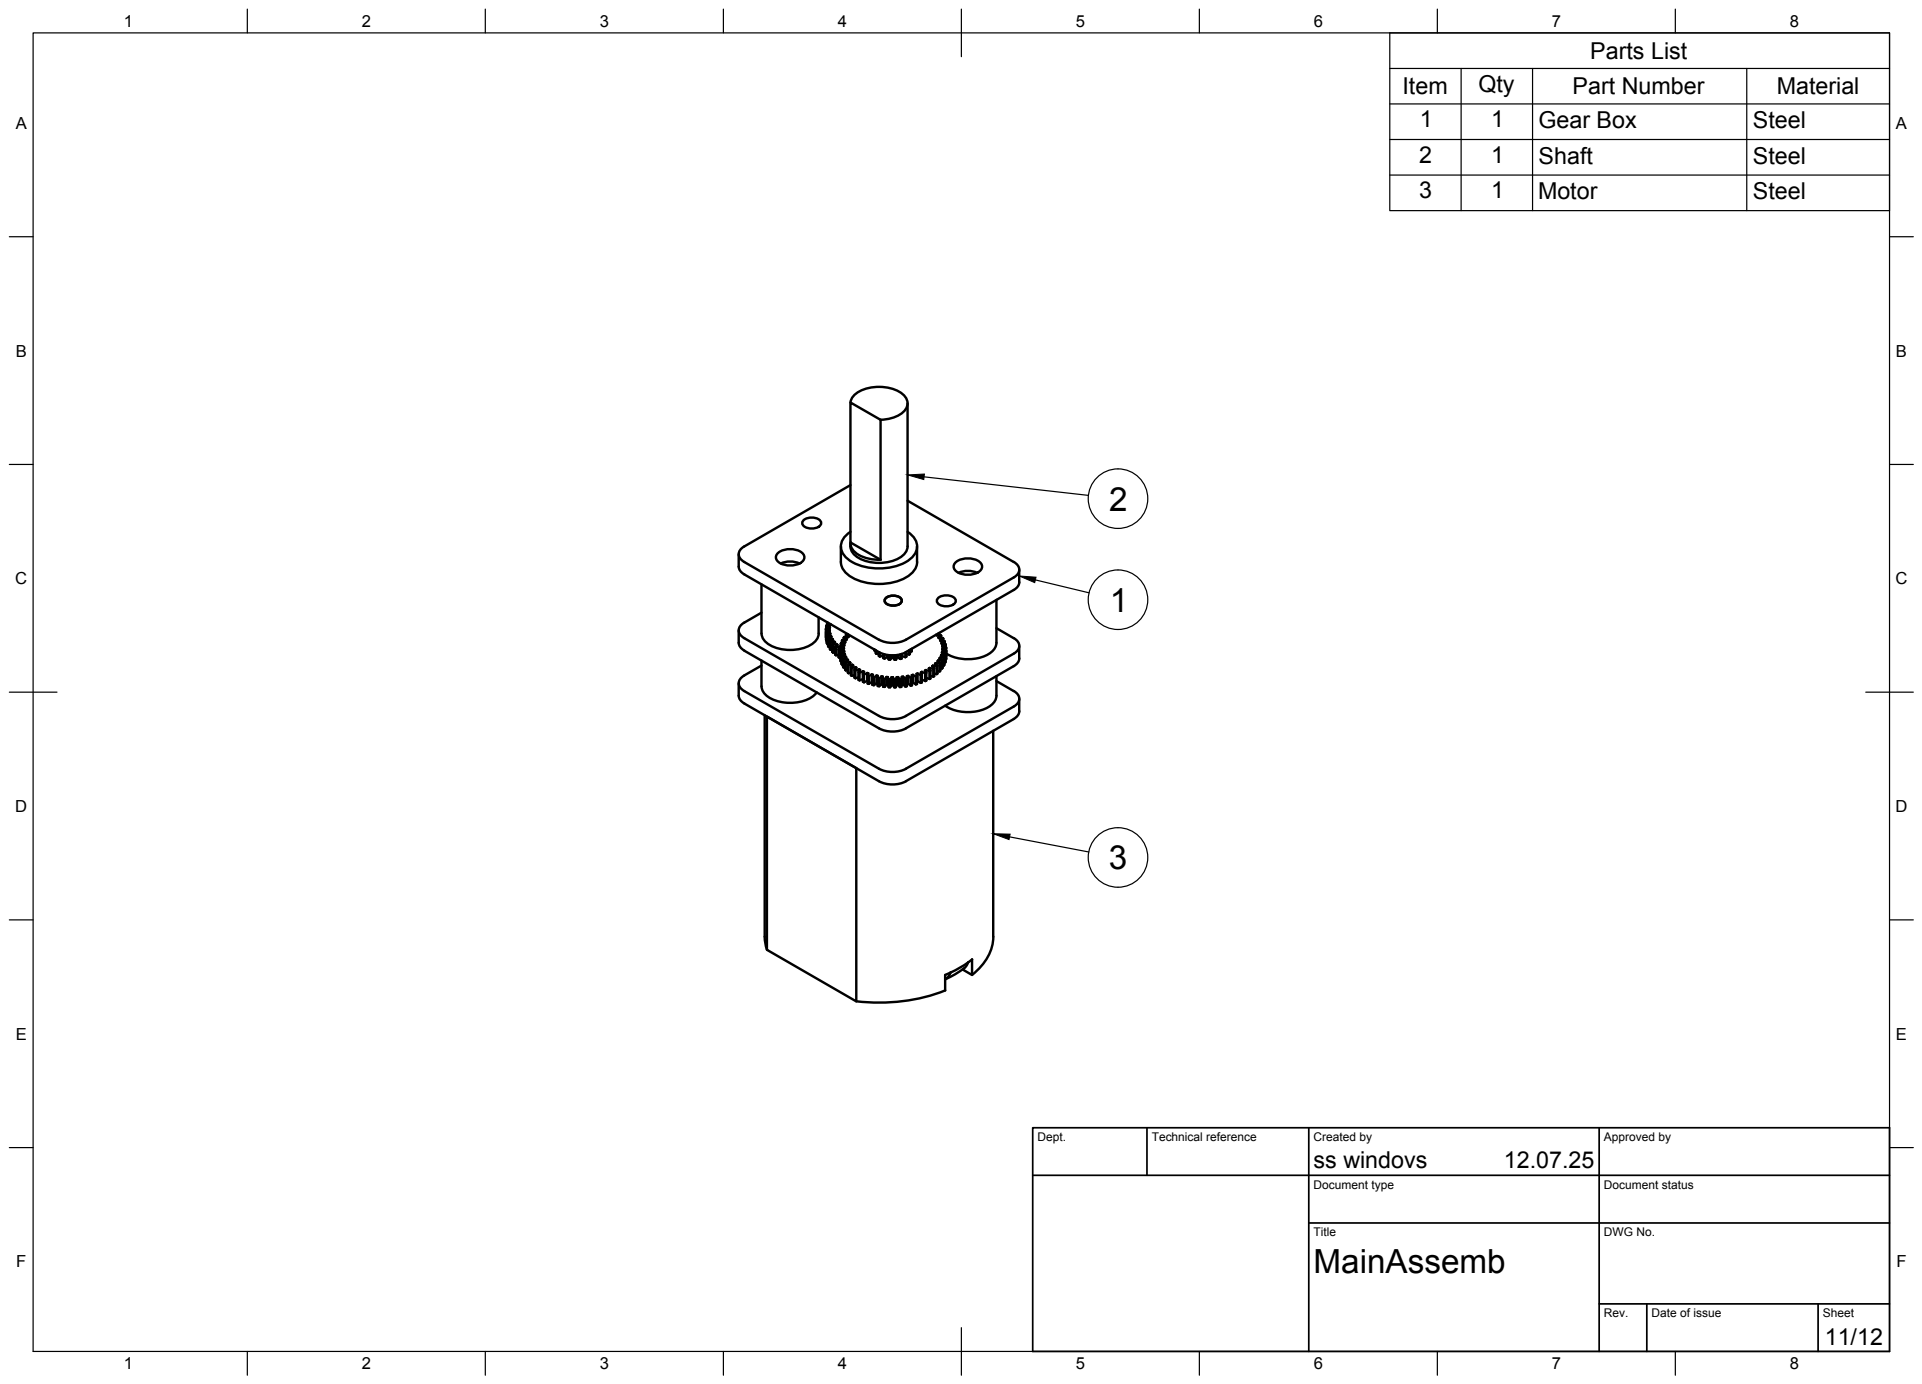
[picture p24: page 11]
Title; DWG No.; Parts List

Item | Qty | Part Number | Material
1 | 1 | Gear Box | Steel
2 | 1 | Shaft | Steel
3 | 1 | Motor | Steel

Dept. | Technical reference | Created by ss windovs 12.07.25 | Approved by

Document type | Document status

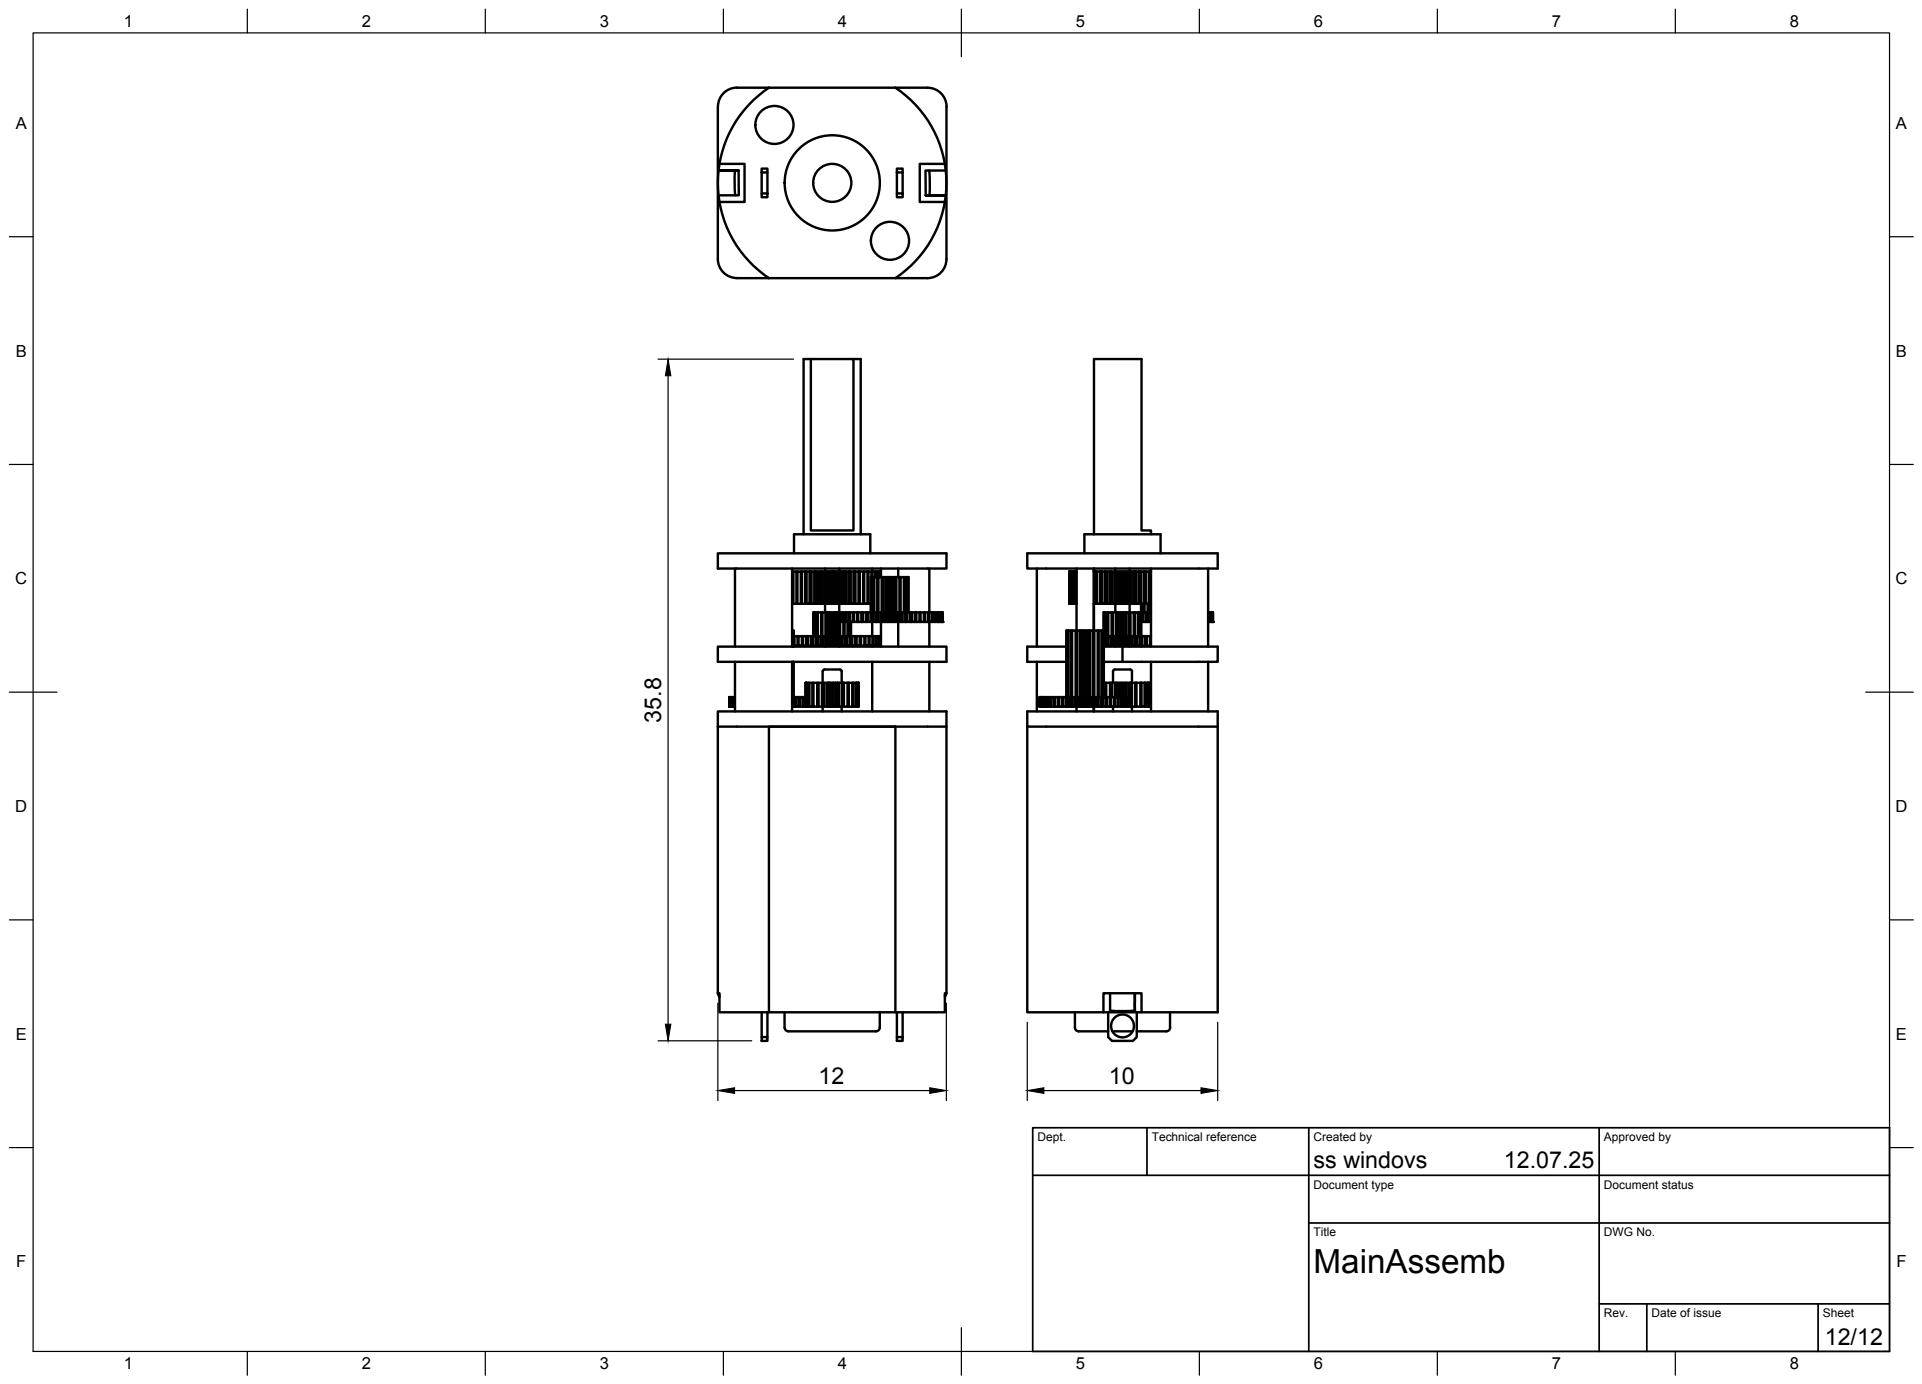
[picture p25: page 12]
Title; DWG No.

Dept. | Technical reference | Created by ss windovs 12.07.25 | Approved by

Document type | Document status
